TahaKeremEris/texecom-premier-smart-alarm/enclosure/preview/2_ustten.png

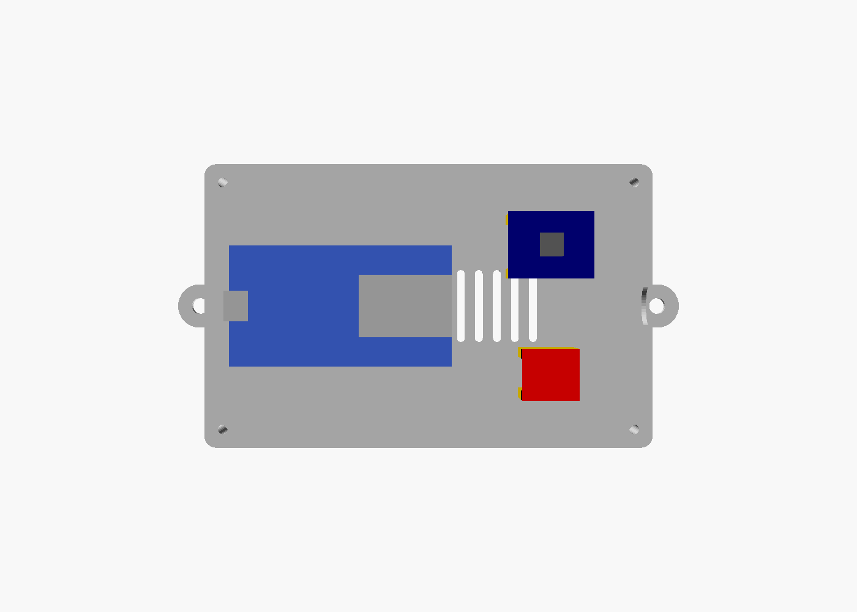
enclosure/preview/2_ustten.png
