TahaKeremEris/texecom-premier-smart-alarm/enclosure/preview/3_ic_yan.png

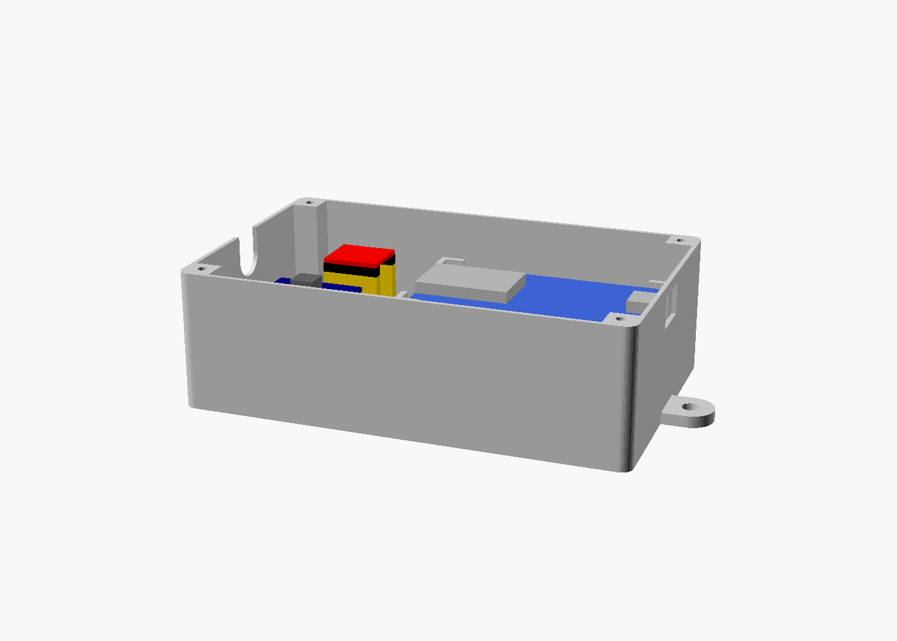
enclosure/preview/3_ic_yan.png
