TahaKeremEris/texecom-premier-smart-alarm/enclosure/preview/4_kapak_baski.png

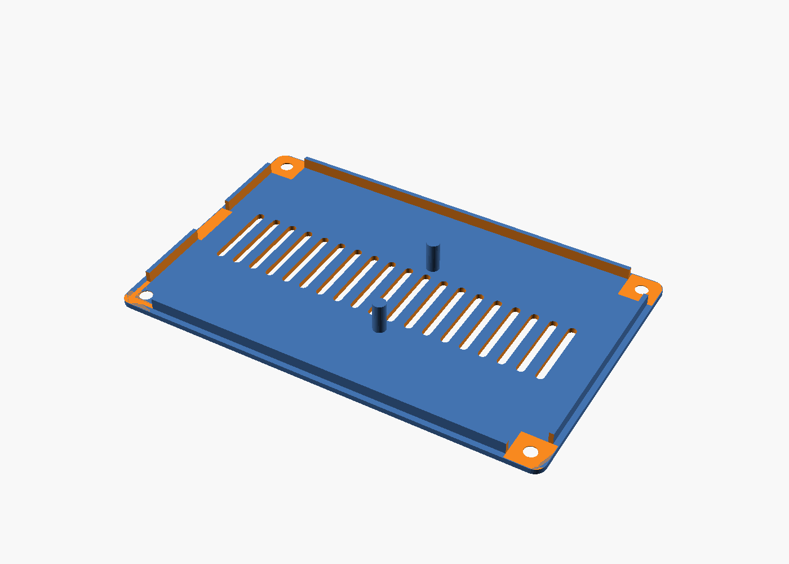
enclosure/preview/4_kapak_baski.png
