TahaKeremEris/texecom-premier-smart-alarm/enclosure/preview/5_kart_yerleri.png

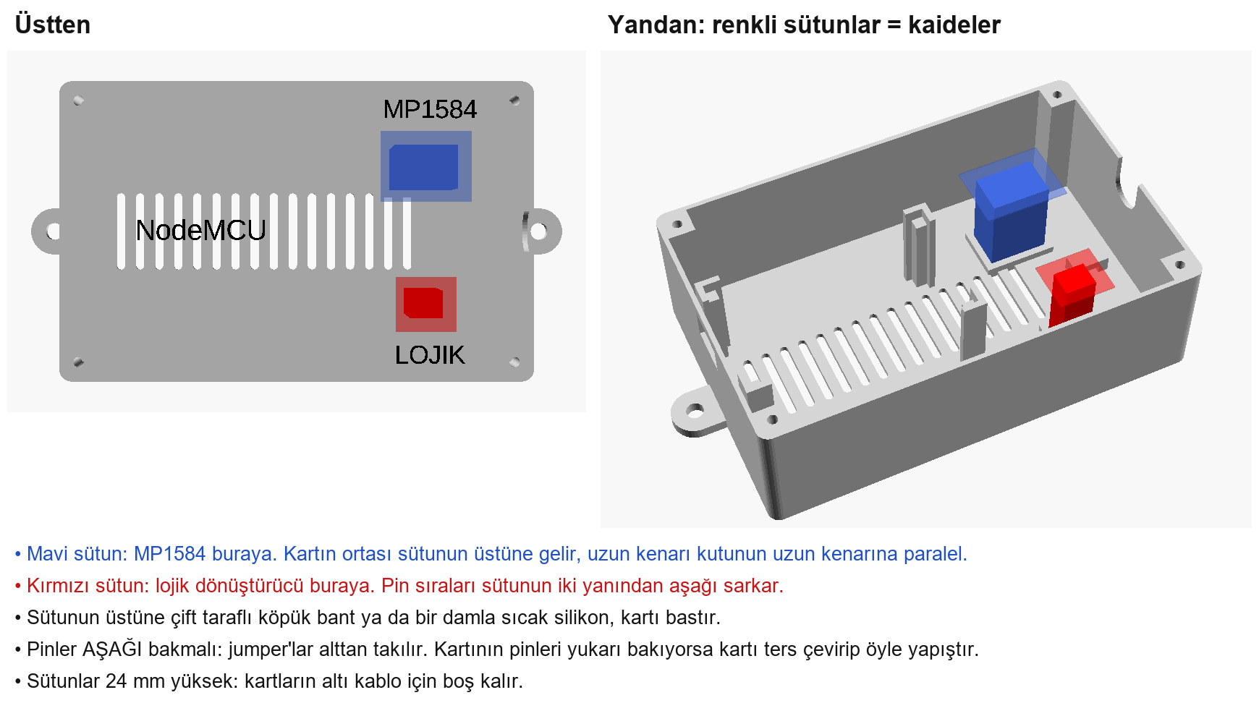
enclosure/preview/5_kart_yerleri.png
