TahaKeremEris/texecom-premier-smart-alarm/enclosure/stl/texecom_kutu_taban.stl

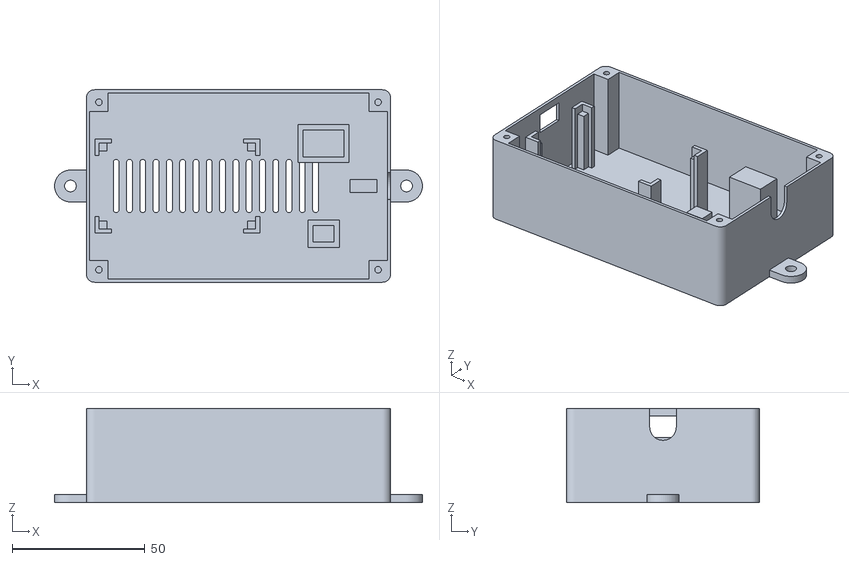
[picture p5: CAD file, 2026-11-11]
enclosure/stl/texecom_kutu_taban.stl
138.4 x 72.4 x 35.4
