TahaKeremEris/texecom-premier-smart-alarm/enclosure/stl/texecom_kutu_kapak.stl

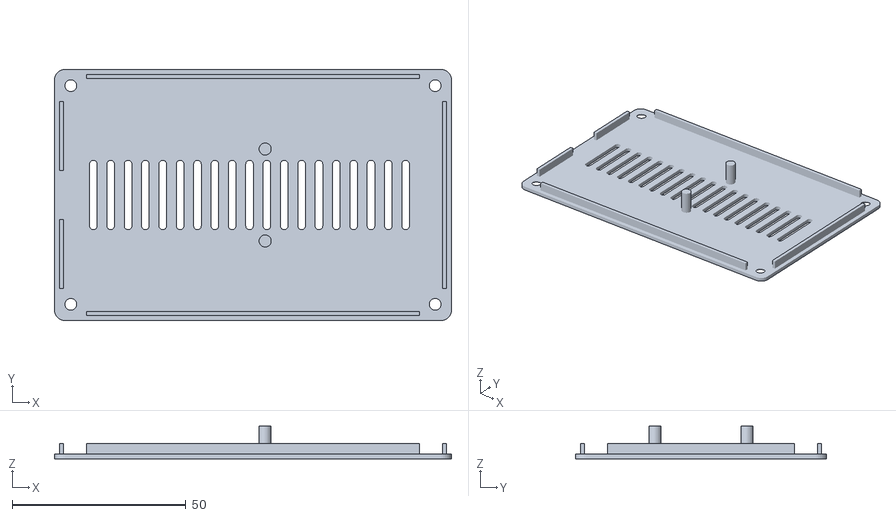
[picture p6: CAD file, 2026-11-11]
enclosure/stl/texecom_kutu_kapak.stl
114.4 x 72.4 x 9.50
