TahaKeremEris/texecom-premier-smart-alarm/enclosure/preview/1_montaj.png

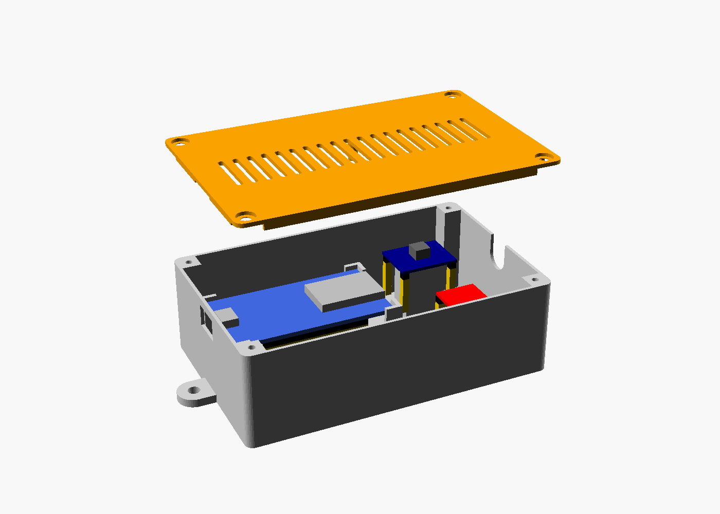
enclosure/preview/1_montaj.png
