TahaKeremEris/texecom-premier-smart-alarm/texecom_sniffer/telegram_root.h

// Telegram (api.telegram.org) sunucu zincirinin koku: Go Daddy Root Certificate Authority - G2, 2038'e kadar gecerli.
// Windows kok sertifika deposundan alindi, gizli degil.
#pragma once
#include <pgmspace.h>
static const char TG_ROOT_PEM[] PROGMEM = R"PEM(-----BEGIN CERTIFICATE-----
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
-----END CERTIFICATE-----
)PEM";
